MattPipan/InvertedPendulum/Render1.png

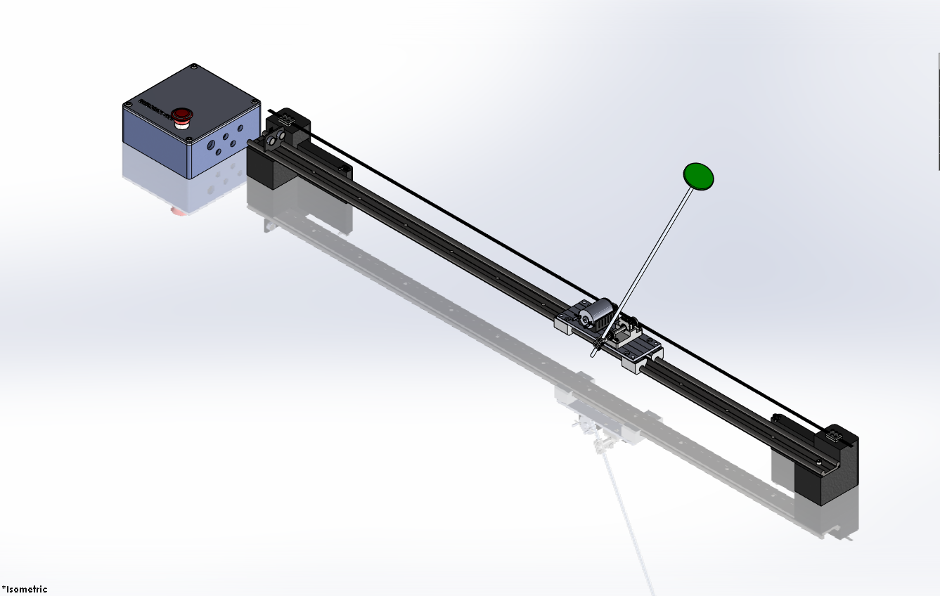
Render1.png
