MattPipan/InvertedPendulum/StepResponse/StepResponse.xlsx

Time (ms) | Angle (counts) | Angle (deg) | Position (cm) | Loop Time
0 | 0 | 0 | 18 | 0
12 | 0 | 0 | 18 | 12
25 | 0 | 0 | 18 | 13
37 | 0 | 0 | 18 | 12
49 | 0 | 0 | 18 | 12
60 | 0 | 0 | 18 | 11
73 | 0 | 0 | 18 | 13
85 | 0 | 0 | 18 | 12
97 | 0 | 0 | 18 | 12
109 | 0 | 0 | 18 | 12
122 | 0 | 0 | 18 | 13
134 | 0 | 0 | 18 | 12
145 | 0 | 0 | 18 | 11
158 | 0 | 0 | 18 | 13
170 | 0 | 0 | 18 | 12
182 | 0 | 0 | 18 | 12
194 | 0 | 0 | 18 | 12
207 | 0 | 0 | 18 | 13
219 | 0 | 0 | 18 | 12
231 | 0 | 0 | 18 | 12
244 | 0 | 0 | 18 | 13
255 | 0 | 0 | 18 | 11
267 | 0 | 0 | 18 | 12
279 | 0 | 0 | 18 | 12
292 | 0 | 0 | 18 | 13
304 | 0 | 0 | 18 | 12
316 | 0 | 0 | 18 | 12
329 | 0 | 0 | 18 | 13
341 | 0 | 0 | 18 | 12
353 | 0 | 0 | 18 | 12
365 | 0 | 0 | 18 | 12
377 | 0 | 0 | 18 | 12
389 | 0 | 0 | 18 | 12
401 | 0 | 0 | 18 | 12
414 | 0 | 0 | 18 | 13
426 | 0 | 0 | 18 | 12
438 | 0 | 0 | 18 | 12
450 | 0 | 0 | 18 | 12
463 | 0 | 0 | 19 | 13
474 | 0 | 0 | 18 | 11
486 | 0 | 0 | 18 | 12
499 | 0 | 0 | 18 | 13
511 | 0 | 0 | 18 | 12
523 | 0 | 0 | 19 | 12
535 | 0 | 0 | 18 | 12
548 | 0 | 0 | 19 | 13
560 | 0 | 0 | 18 | 12
572 | 0 | 0 | 18 | 12
585 | 0 | 0 | 18 | 13
596 | 0 | 0 | 18 | 11
608 | 0 | 0 | 18 | 12
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
